bradleyasu/TimeBlaster_Services/assets/brand/joctv-timeblaster.png

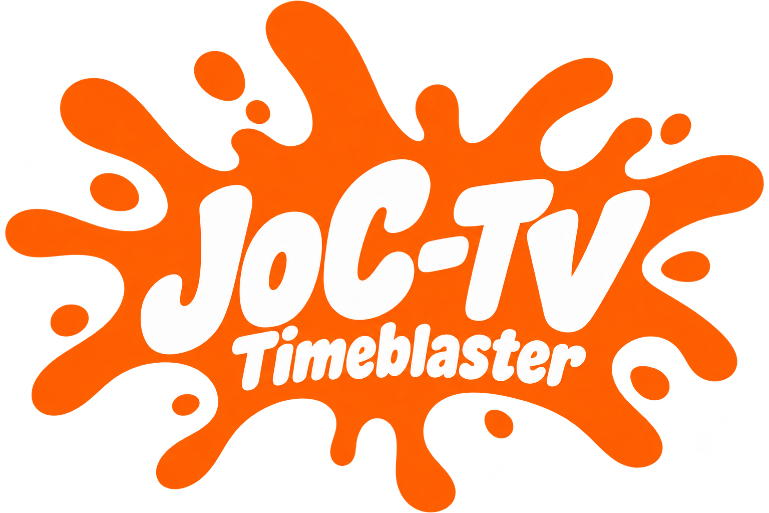
assets/brand/joctv-timeblaster.png
