bradleyasu/TimeBlaster_Services/deploy/assets/booting.png

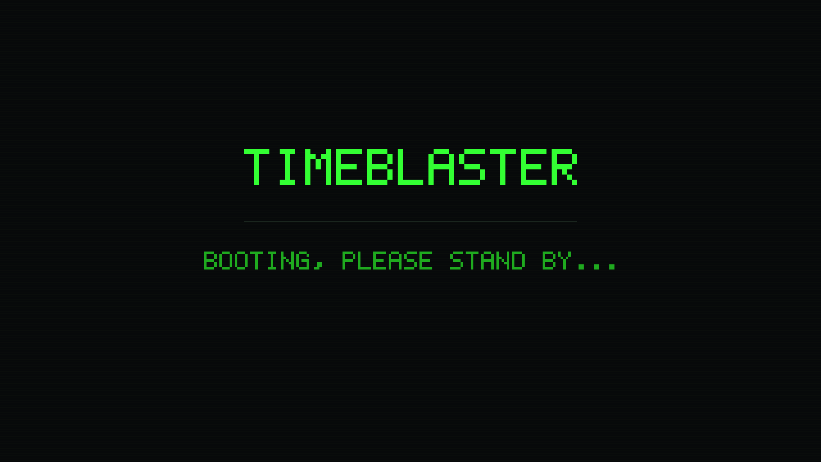
deploy/assets/booting.png
