bradleyasu/TimeBlaster_Services/deploy/assets/ersatztv-offline.png

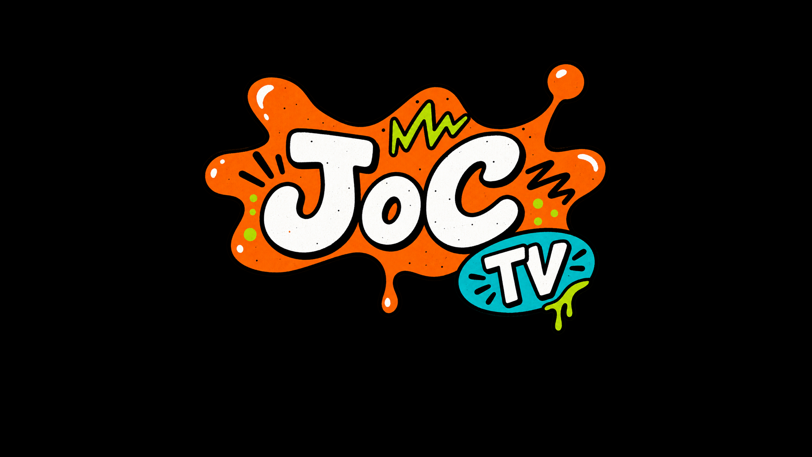
deploy/assets/ersatztv-offline.png
