bradleyasu/TimeBlaster_Services/deploy/assets/no-channel.png

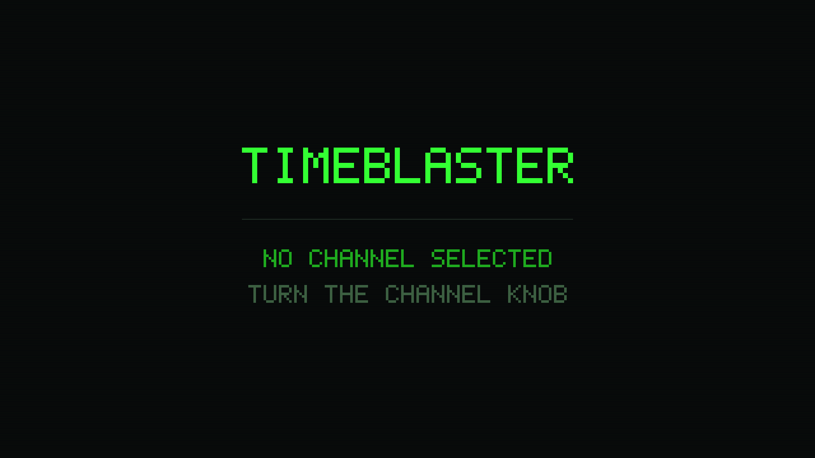
deploy/assets/no-channel.png
