bradleyasu/TimeBlaster_Services/firmware/timeblaster-nano/src/Protocol.h

#ifndef TIMEBLASTER_PROTOCOL_H
#define TIMEBLASTER_PROTOCOL_H

#include <Arduino.h>

// The TB1 wire format spoken with the Raspberry Pi over USB CDC serial.
//
//   <STX> TB1 | SEQ | TYPE | arg | arg ... | CRC <LF>
//    0x02  ^------------ checksummed region ------^   0x0A
//
// The same format is implemented in Go in internal/protocol, and that package's
// tests pin the exact bytes and cross-check this CRC against a transcription of
// the implementation below. A change on either side that breaks compatibility
// fails a test rather than a bench session.
//
// See docs/serial-protocol.md for the full specification.

static const char PROTOCOL_STX = 0x02;
static const char PROTOCOL_ETX = '\n';
static const uint16_t PROTOCOL_MAX_FRAME_LEN = 512;
static const uint16_t PROTOCOL_MAX_SEQ = 4096;
static const uint8_t PROTOCOL_MAX_ARGS = 6;

// A decoded inbound frame.
struct Message {
  String type;
  String args[PROTOCOL_MAX_ARGS];
  uint8_t argc;
};

// CRC-8, polynomial 0x07, init 0x00.
uint8_t protocolCRC8(const char* data, size_t len);

// Sending. Each returns once the frame has been written to Serial, or
// immediately without sending if the transmit buffer has no room for it -- see
// protocolDroppedFrames. Nothing here ever blocks waiting for the host.
void protocolSend(const String& type, const String* args, uint8_t argc);
void protocolSend0(const String& type);
void protocolSend1(const String& type, const String& a);
void protocolSend2(const String& type, const String& a, const String& b);

// protocolSendPing sends the liveness beacon: uptime, the dropped-frame count,
// and the firmware version. The version rides on every PING rather than only
// on HELLO because HELLO is easily missed -- the Nano sends it once at boot,
// often before the Pi has opened the port, and a restarted daemon never sees
// it at all. The Pi needs the version to know whether an update is available.
void protocolSendPing(uint32_t now, const char* version);

// protocolDroppedFrames counts frames abandoned because the USB CDC transmit
// buffer was full, rather than blocking loop() waiting for the host. Reported
// in every PING, so a transmit path that is quietly discarding everything is
// visible from the Pi instead of only at the device.
uint32_t protocolDroppedFrames();

// protocolLastTxOkMs is millis() at the last frame actually written, or zero if
// nothing has been sent yet.
uint32_t protocolLastTxOkMs();

// protocolMsSinceTxOk is how long ago the last frame was written, as seen from
// now. Never negative, even when that frame went out after now was sampled --
// see msSince in Protocol.cpp for why that matters.
uint32_t protocolMsSinceTxOk(uint32_t now);

// protocolTxStalled reports whether sending has stopped working while the Pi is
// still being heard from.
//
// That asymmetry is the whole signal. A Nano that cannot transmit has no way to
// report it, so it has to notice by itself: messages keep arriving, nothing
// leaves, and the only cure is a restart.
bool protocolTxStalled(uint32_t now, uint32_t lastRxMs,
                       uint32_t txStallMs, uint32_t rxFreshMs);

// protocolResetTxHealth forgets the transmit history, for tests and after a
// deliberate re-initialisation.
void protocolResetTxHealth(uint32_t now);

// protocolPoll reads available bytes and invokes handler for each complete,
// checksum-valid frame. Anything before an STX is discarded, which is how the
// link resynchronises after a reset or a half-transmitted frame.
void protocolPoll(void (*handler)(const Message&));

#endif // TIMEBLASTER_PROTOCOL_H
