bradleyasu/TimeBlaster_Services/(commit log)

2026-09-18 Timeblaster: Raspberry Pi alarm clock and television appliance
    A complete appliance stack: a Go daemon (timeblasterd) that owns alarm
    scheduling, hardware I/O, television playback and a companion PWA; a
    privileged network helper; and Arduino Nano ESP32 firmware.
    The design rule throughout is that the alarm clock is the highest-priority
    function and nothing else may compromise it. internal/alarm depends only on
    storage, a clock and an audio sink; the health endpoint reserves "unhealthy"
    for an impaired alarm path; alarms ring with every sound file deleted, with
    the database read-only, and with ErsatzTV, mpv, the Nano and the network all
    broken at once.
    Every out-of-process dependency sits b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
2026-09-22 firmware: drive the display with the proven 74HC595 driver
    The display firmware I wrote assumed directly driven, multiplexed,
    common-cathode digits on twelve GPIO pins. The real hardware is nothing like
    that: four 74HC595 shift registers on three pins (D5/D6/D7), one register per
    digit, latched and not multiplexed, driving two common-anode HDSP-K511 dual
    displays through 32 x 360R resistors.
    Every assumption differed. The segment bit order is A,B,F,G,C,D,E,DP from bit 7
    rather than a=bit0; segments are active low, so the driver inverts before
    shifting; the first byte clocked out lands on the rightmost digit; and ~OE is
    tied low, so there is no hardware dimming at all. My LED pins for Wi-Fi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
    [Arduino.cpp, Arduino.h, Display.cpp, Display.h, Inputs.cpp, Inputs.h, Pins.h, Protocol.cpp]
2026-09-22 Make the display a switch, and animate while the Pi boots
    The 7-segment display has no dimmer: the 74HC595s' ~OE is tied low and is not
    brought out on J2. A 0-100 brightness slider that did nothing except at zero was
    a lie, so the display is now a switch everywhere it is exposed:
    general.display_on, a toggle in the companion app, and hardware.SetDisplayOn.
    The wire format is deliberately unchanged. DISPLAY|BRIGHTNESS keeps its 0-100
    field so a board with ~OE wired would need no protocol change; the Pi now only
    ever sends 0 or 100, and the firmware blanks at 0 and lights otherwise. The
    firmware, the protocol package and the interop fixture are all untouched.
    Devices that stored a brightness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
    [Display.cpp, test_firmware.cpp]
2026-09-22 Make the television boot like an appliance, not a Linux box
    Three separate things showed on HDMI before mpv got the display, and each
    needed its own fix. Kernel messages and the Raspberry Pi logos: quiet,
    loglevel=3, logo.nologo, and console=tty3 so anything slipping past lands on a
    VT the television never shows. systemd's [ OK ] lines: systemd.show_status.
    And the one that actually mattered -- the Debian login prompt, which would sit
    on the television forever if the daemon ever failed to start.
    The getty on the television's VT is now disabled, with one enabled on tty2 in
    its place. Without that escape hatch a Pi with no network and no serial console
    would have no way in at all; SSH is unto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
2026-09-22 Fix five faults found on the first real install
    Diagnosed over SSH on the Pi rather than from the symptoms alone.
    1. Two units declared RuntimeDirectory=timeblaster as different users, so
    whichever started first owned /run/timeblaster. The root wifi helper won and
    created it 0750 root:root, leaving the unprivileged daemon unable to write
    its mpv IPC socket, write its fallback alarm tone, or even traverse the
    directory to reach the helper's own socket. That one race produced three of
    the four red lines in tbctl health: tv_player, alarm_sounds and wifi_helper
    (and network, which follows from wifi_helper). The journal named it exactly:
    "connect: permission denied" on mpv-t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
2026-09-22 ersatztv: read channels from the IPTV playlist, not the authenticated API
    On the Pi, ErsatzTV v26.10.0 answers /api/channels with 401 to an anonymous
    caller, so Timeblaster reported ersatztv down against a server that was fully
    healthy and serving its web UI. The IPTV playlist at /iptv/channels.m3u is open
    -- it is what Plex, Jellyfin and Kodi consume -- and carries everything needed:
    channel-number, tvg-name, and the stream URL.
    Switching to it means no credentials and no configuration to discover channels,
    and it keeps working if the API's auth rules change again.
    The parser is pinned against a playlist captured verbatim from the running
    server, and covers the shapes that would otherwise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
2026-09-22 setup.sh: reload systemd when any unit changes, not just the timeblaster ones
    install_services only reloaded when one of its own two units changed, so a
    rewritten ersatztv.service landed on disk and was then ignored: systemd printed
    'unit file changed on disk, run daemon-reload' and the restart that followed
    reran the stale unit. The FFmpeg PATH change looked installed and did nothing.
    Any unit write now sets a flag and systemd is reloaded once, before the
    services are enabled and started.
2026-09-22 setup.sh: always reload systemd, do not try to be clever about it
    The conditional reload was a bug factory. A unit could be correct on disk while
    systemd still ran a stale copy -- which is what happened to ersatztv.service:
    one run rewrote it without reloading, the next saw the file already matched and
    skipped, and systemd kept the old copy either way. Two runs in a row, neither
    wrong on its own, and the FFmpeg PATH never took effect.
    A daemon-reload costs a few hundred milliseconds and is idempotent.
2026-09-22 docs: explain ErsatzTV's hardware-acceleration warning on a Pi
    ErsatzTV reports every channel as 'not configured for hardware acceleration
    (Nvenc)' on a Raspberry Pi. It is a false positive and acting on it breaks
    playback: NVENC is NVIDIA's encoder and there is no NVIDIA GPU, and the Pi 5
    has no hardware video encoder at all -- the Pi 4's H.264 block is gone, leaving
    an HEVC decoder and the camera ISP. Both h264_nvenc and h264_v4l2m2m fail
    outright on the device, which is what the note records.
    Leaving hardware acceleration set to None is the only correct setting there.
    The lever that matters on a Pi is not transcoding at all.
2026-09-22 One decider for the television, applied in order
    On the Pi, with the channel knob connected, ErsatzTV coming up produced these
    two lines three milliseconds apart:
    11:42:12.493 channel change number=1 name=ErsatzTV
    11:42:12.497 no channel selected; showing the static image
    The knob had chosen channel 1 and the standby image immediately overwrote it.
    The television played the channel while the daemon reported no channel
    selected, so /api/state, the companion app and the overlay were all wrong.
    Two faults compounding. Refresh announced the new channel list -- which makes
    the knob re-evaluate and select, asynchronously, because loading a stream takes
    seconds and must not block the input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
2026-09-22 Hold the channel banner until the picture arrives
    The banner hid on a fixed 2.5s timer measured from when the channel was
    requested, but tuning takes longer than that: watching mpv's event stream on
    the Pi, playback-restart lands about 1.3 seconds after the request when the
    channel is warm, and considerably later when ErsatzTV has to cold-start it. So
    'CH 1' appeared over the previous content, expired, and the picture turned up
    seconds afterwards with nothing on screen to explain the wait.
    A television keeps the channel number up until the picture does. The banner now
    holds until mpv reports playback-restart and only then runs its normal course,
    with channel_overlay_max_hold as a safety net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
2026-09-24 Fix a doubled space in sound names with a separator
    displayName inserts a space for a '-' or '_' separator and another at a
    letter-to-digit boundary. With "alarm_1" both rules fire on the same
    position, so the library offered "Alarm 1".
    The existing test only covered "alarm1", which takes neither path, so
    the form real files are named in was never exercised. Tracks whether a
    separator already supplied the space.
2026-09-24 Make Wi-Fi setup survive a failed join
    Four defects, each of which left the device in a state the user could
    not get out of without physical access.
    The captive portal binding 10.42.0.1:80 failed whenever anything else
    held the wildcard :80. EnterSetup logged that and carried on, so the
    access point came up with no portal behind it: the Pi had already left
    the user's network and could be neither reached nor configured until the
    fifteen-minute timeout expired. It now rolls back.
    The join itself never worked. `nmcli device wifi connect` infers the
    security type from the scan list, and a radio coming straight out of
    access-point mode has no usable scan, so the passphrase was attached to
    a pro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
2026-09-24 Say what the device is doing during a channel change
    A cold tune takes around nine seconds on a Pi 5, nearly all of it
    spent encoding the first HLS segment, and mpv holds the outgoing
    channel's last frame until the new one decodes. The wait therefore
    looked exactly like a picture that had frozen.
    The television now shows a full-screen card -- channel number, animated
    dots, painted over the frozen frame -- drawn before the load rather
    than after it, so it is up before the old picture stops moving. The
    seven-segment display flashes the channel the way a television does.
    Anything that writes to the display takes a claim generation, so a
    banner timing out cannot wipe a message something else h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
2026-09-24 Find Go by path when it is not on PATH
    setup.sh installs Go under /usr/local/go, which Raspberry Pi OS adds to
    no shell's PATH -- not even a login one. `make build` on the Pi
    therefore failed with "go: command not found", which is exactly what
    `make update` needs to work.
2026-09-25 Reject impossible alarm times instead of clamping them
    A number input does not stop anyone typing 75, and the editor quietly
    turned that into 23 in 24-hour mode, or into midnight in 12-hour mode.
    The alarm saved, reported success, and went off at a time the user never
    asked for -- which is the one failure an alarm clock cannot have, and a
    silent correction is indistinguishable from it having worked.
    The two fields were also inconsistent: the hour clamped locally while
    the minute was passed through untouched and rejected by the server with
    a 400, so the same class of mistake produced two different behaviours.
    editorTime now validates both and reports which field is wrong, marking
    it until i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
2026-09-25 Fix a stale assertion left by the rename to editorTime
    editorHour24 became editorTime when the editor started rejecting
    impossible times rather than clamping them, and the test still named
    the old function. It was pushed red.
    Also checks that saveAlarm looks at the returned error, so the clamping
    behaviour cannot quietly come back with the function keeping its name.
2026-09-25 Stop a knob that is not there from setting the alarm volume
    The alarm volume wandered between 10% and 22% on its own. The volume pot
    is not wired to the Nano yet, and an unconnected analog pin does not
    read zero -- it floats at whatever charge its input capacitance holds,
    coupled from the neighbouring channels of the multiplexed ADC.
    Measured over ten samples with nothing attached:
    channel (connected) 1.000 every sample
    volume (floating) 0.128 .. 0.219
    reserved A 0.085 .. 0.134, rising and falling with volume
    That last correlation is the giveaway: the two floating pins move
    together, which is crosstalk rather than anything either of them is
    measuring.
    The knob is auth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
2026-09-28 Load cdc_acm at boot so the serial port stays reachable
    If the Pi boots with the Nano detached and it is plugged in afterwards,
    the daemon can never open the port. It retries forever against
    "operation not permitted" and only a restart clears it.
    The cause is an ordering race with systemd's device filter. The unit
    hardens itself with
    DeviceAllow=char-ttyACM rw
    and systemd resolves "char-ttyACM" by looking "ttyACM" up in
    /proc/devices at the moment it builds the service's cgroup filter. That
    major number comes from cdc_acm, which is not preloaded and only loads
    on demand when the first ACM device enumerates. If that has not happened
    yet, systemd finds no entry, silently drops the rule, a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
2026-09-29 Show the alarm volume on the clock while the knob moves
    Turning the volume knob now puts the level on the seven-segment display
    the way a stereo does, and the clock returns about a second and a half
    after the knob stops.
    "V" and a right-aligned number is exactly the four cells available for
    every value from 0 to 100 -- "V 0", "V 44", "V100" -- so there are no
    special cases. V rather than U because this font draws it with a pointed
    base, which no digit resembles.
    Only a physical turn shows it. A change made from the companion app
    would otherwise flash the clock at someone who is not in front of the
    device.
    Each turn re-claims the display and restarts the timer, which the claim
    generation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
2026-09-29 Stop the guide's channel chips touching the REFRESH button
    .row-head is a flex container, so the heading's own bottom margin sits
    inside it and leaves no space below. The TV tab gets away with it
    because a .hint follows, bringing its own spacing. In the guide the
    chips follow directly and had no top margin, so two tappable controls
    met with nothing between them.
2026-09-29 Clear the playback handle when a preview hits its time limit
    watch had two exits and only one of them cleaned up. A preview that ran
    to its time limit stopped the player and returned, leaving the handle
    set for the rest of the service's life. IsPlaying then reported true
    forever, so the companion app showed a preview still playing long after
    the speaker had gone quiet.
    Observed on the device: the card went Running at 1s and Stop at 10s
    exactly as configured, while /api/state still said playing at 20s.
    Both paths now converge on the same cleanup. A stop we asked for is not
    recorded as a player failure, which it otherwise would be -- the process
    reports being killed, and that is the answer t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
2026-09-29 Raise the sound preview cap to 60 seconds
    Ten seconds is too little to judge an alarm sound: the files here run
    for minutes, so a preview was playing about four per cent of one.
    Still a cap rather than the whole file, because without one the only way
    out of a preview is the stop button.
2026-09-29 Send the television's audio to HDMI, with a switch for the speaker
    mpv was launched with --audio-device=auto, which follows the ALSA
    default. ALSA's default is card 0, and cards are numbered in enumeration
    order -- so plugging in the USB speaker made it card 0 and the
    television's sound started coming out of it.
    Observed on the device after the speaker was fitted:
    0 [UACDemoV10]: USB-Audio - UACDemoV1.0
    1 [vc4hdmi0 ]: vc4-hdmi - vc4-hdmi-0
    2 [vc4hdmi1 ]: vc4-hdmi - vc4-hdmi-1
    The same card had been number 2 earlier the same day.
    The device is now always chosen by card name, and HDMI is the default
    even when the attached display has no speakers: a monitor that cannot
    make a noise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
2026-09-29 Make the TV audio test actually test the speaker branch
    It asserted only that the device string contained "CARD=". Falling
    through to HDMI produces a CARD= string too, so the assertion held
    whether the speaker branch ran or not -- disabling that branch entirely
    left the test green.
    It now names the resolved speaker card and rejects an HDMI device.
2026-09-29 Reload playback when the TV audio output changes
    Setting mpv's audio-device does nothing to a stream that is already
    playing. When an audio output fails to open -- an HDMI sink with no
    speakers behind it -- mpv gives up on audio for that playback session
    and leaves the track deselected. Pointing it at a working device
    afterwards changes nothing, and selecting the track by hand is silent
    too, because the output object was never created.
    Observed on the device: aid=False with an aac track present, setting
    aid=1 selected it, and the USB card still read Stop. Reloading the file
    brought it up Running and it stayed there.
    Changing the setting now reloads whatever is on screen. The reconnect
    path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
2026-09-29 Use the alarm list's switch for the settings toggles
    Bare checkboxes beside the alarm list's switches looked like two
    different applications. The three settings toggles now use the same
    control.
    No JavaScript changed: the inputs keep their ids, so reading .checked
    still works. .field > span and .field.toggle > span both use the child
    combinator, so nesting a switch inside a label does not collide with the
    label's own text styling.
    A test pins the structure. The switch is styled through
    `.switch input:checked + span`, an adjacent sibling selector, so the
    track has to come immediately after the input -- get that wrong and the
    control renders but never visibly changes state, which looks dead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
2026-09-29 Apply settings as they are changed and drop the save button
    Every control now saves itself, matching the alarm list's switches,
    which have always worked this way: act on change, say nothing on
    success, snap back with an explanation if the device refuses.
    Two things needed care. The API compares a whole settings document
    rather than patching fields, so each request is built from the controls
    rather than from the last saved copy -- two changes in quick succession
    then both survive, because each request carries the complete intent and
    the later cannot undo the earlier.
    The timezone is the exception. It is typed rather than chosen, so
    mid-edit its value is half a word that would fail validatio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
2026-09-29 Trust a hardware clock that survived the power cut
    The seven-segment display holds its loading animation until the system
    clock is trustworthy, and the only thing that counted as proof was
    systemd-timesyncd's synchronized marker. That marker is an NTP-only
    signal, so fitting the RTC coin cell -- which fixes the exact problem
    the wait exists for -- bought nothing: the Pi knew the time at boot and
    still animated for half a minute.
    17:35:36 rpi-rtc: setting system clock to 2026-09-29T21:35:36 UTC
    17:35:45 holding the clock display until the system clock is synchronised
    17:36:11 system clock synchronised; sending the time to the Nano
    Read /sys/class/rtc/rtc0/since_epoch as a sec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
2026-10-01 Stop a dead channel wedging the Nano, and report it when it does
    Three faults that combined into one silent failure. Channel 1 cannot be
    served by ErsatzTV, so its stream ended the instant it loaded and the
    reload-on-failure path retried it forever: 22541 reloads in 19 hours.
    Every channel change flashes the number on the seven-segment display, so
    that loop also put tens of thousands of unsolicited writes down the
    serial link. Some hours in the Nano stopped transmitting altogether and
    never resumed -- 15 hours mute, zero bytes on a raw read, while still
    enumerated on the bus.
    None of it showed up. The status page read OK because Connected meant
    "the port opened", and LastMessageAt was stamp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
    [Arduino.h, Protocol.cpp, Protocol.h, test_firmware.cpp]
2026-10-01 Stop a wedged Nano filling the journal and churning the PWA
    A board that opens but never answers made the reconnect loop succeed and
    fail every heartbeat window, and every cycle was logged in full: six
    lines each, 39478 of them overnight, none saying anything the first three
    had not. Each cycle also emitted a LinkUp/LinkDown pair, and since every
    hardware_changed event makes the app refetch the whole snapshot, it was
    costing two full refetches per cycle in every connected phone.
    - Send LinkUp when the Nano first speaks rather than when the port opens,
    and LinkDown only if LinkUp was sent. An open port is not a working
    link. Resync still runs at connect, because putting the time on the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
2026-10-01 Report free disk space as a health component
    The device has 20GB free on a 469GB card that is 96% full of media, and
    nothing on it could say so. Running out does not fail loudly: SQLite stops
    being able to checkpoint and ErsatzTV stops being able to write its
    database, with no indication of why. This makes the decline visible while
    there is still room to act on it.
    system.Statfs reads the filesystem, behind a Disk interface so the
    thresholds are testable without filling a real disk. AvailBytes is used
    rather than total free space, because the reserved-for-root fraction is
    space this daemon cannot actually have.
    Thresholds are configurable and default to 5 GiB degraded, 1 GiB down.
    The firs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
2026-10-01 Cap persistent logging instead of discarding it at reboot
    Raspberry Pi OS ships Storage=volatile to spare the SD card write wear, so
    the journal lived in RAM and every log was lost at reboot. That is the
    wrong trade for a device meant to run unattended for months: diagnosing
    the recent Nano fault depended on 15 hours of history that only survived
    because the Pi happened not to restart.
    Overrides it with persistent storage and real bounds: 200M total, 20M per
    file, one month retention, 64M for the runtime journal before /var is
    available.
    SystemKeepFree=1G is the line that makes this work rather than quietly
    fail. It defaults to 15% of the filesystem, which on a 469GB card demands
    roughly 7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
2026-10-01 Stop USB audio freezing the picture, and recover if it does
    Routing television audio to the USB speaker froze playback. Caught in the
    act: ALSA held in PREPARED with appl_ptr=0 -- the device configured and
    never fed a single frame -- and mpv stuck in its startup seek with
    time-pos pinned at 0. No kernel or USB events, the device still
    enumerated, every mpv thread in futex_do_wait, so nothing was blocked in
    the driver. It sat frozen for six minutes until a channel change cleared
    it.
    The speaker accepts exactly one format: S16_LE / 2ch / 48000, one altset,
    full speed, bus powered. Roughly half the library is 44.1 kHz, and because
    the channels are HLS Direct with -c:a copy the source rate reac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
2026-10-01 Show install instructions instead of the app in a browser
    Opened as a web page the companion app now shows how to add it to the home
    screen and nothing else: body.gated hides every other section plus the tab
    bar and the connection dot, and the app is never wired up, so it does not
    connect, poll, or call the API while gated.
    Instructions are per browser, because the only question that matters --
    which menu hides Add to Home Screen -- is a question about the browser and
    nothing feature-detectable answers it. iOS Safari gets the Share sheet
    steps; iOS Chrome and Firefox are told to open Safari, since on iOS only
    Safari can install; Chromium gets its menu or address-bar install, and a
    real one-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
2026-10-01 Use the hand-made JoC-TV logo for the app icon
    The icons were a splat drawn in primitives, standing in for artwork that
    did not exist yet. It does now, so they are derived from it instead:
    redrawing a hand-made logo in code would be a copy that drifts from the
    original every time either changes.
    assets/brand/joctv-timeblaster.png is the master. make-assets.py grows a
    small stdlib PNG decoder, a box-filter resize and an alpha composite to
    derive the icons from it -- stdlib because the Pi has no image library and
    setup.sh regenerates assets there. A box filter rather than nearest
    sampling: this is a large reduction and point-sampling fine white
    lettering breaks the strokes.
    The logo is lands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
2026-10-01 Show an offline screen when the Timeblaster cannot be reached
    Losing the device left the app looking broken rather than offline: refresh()
    swallows its error by design, so every panel simply rendered empty with a
    dimmed dot in the corner as the only clue.
    A full-screen overlay now says so plainly, with the logo, what to check, and
    when the device was last reached. It is an overlay rather than a body class
    like the install gate because this state is transient -- the app keeps its
    state underneath and comes back intact the moment the device answers.
    Two grace periods, because the two cases look identical to the code and very
    different to a user. A session that has connected before is usually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
2026-10-01 Set alarm times with the platform's time picker
    Setting an alarm meant typing into two number fields and tapping an AM/PM
    pair, which raises a keyboard on a phone for something every platform already
    has a wheel for. A native time input replaces all three: on iOS it is the
    Clock app's hour / minute / AM-PM drums, on Android the platform picker, on a
    desktop a spinner field.
    Most of what the old controls needed in code goes with them. A picker cannot
    express 75:43, so the hour and minute range checks that existed to catch it
    are gone, along with the 12-to-24 hour conversion and the AM/PM radio pair --
    the value is always 24-hour HH:MM however it is displayed.
    editorTime still rejects rather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
2026-10-03 Let the Nano restart itself when its transmit path dies
    Second occurrence of the same fault: the USB CDC transmit path stops working
    while everything else keeps running. The display updates, messages from the
    Pi still arrive, and nothing the Nano sends ever gets out again. Last night
    it went mute mid-burst while the knob was being turned, and stayed mute.
    The guard added last time did not prevent it, and could not have. That was
    built on the theory that a blocking Serial.write was stalling loop(), but
    loop() is demonstrably alive -- the clock on the display stays correct, and
    it is redrawn there. Only transmitting is dead. On an ESP32-S3 with native
    USB that points at the TinyUSB side wedgi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
    [Protocol.cpp, Protocol.h, main.cpp, test_firmware.cpp]
2026-10-03 Drop the channel-overlay switch from the app; it is always on
    A front-end change only, as asked: the device keeps the setting, the storage
    key and the plumbing, so re-adding the control later is putting the markup and
    the three lines of wiring back.
    The one subtlety is that the field still has to be sent. applySettings
    compares the whole settings document against what the device holds, so a
    missing bool decodes as false, differs from the stored true, and switches the
    overlay off -- permanently, because the control that could undo it is the one
    being removed. It now sends true unconditionally, with a guard that fails if
    that ever stops being the case.
    Verified the stored value on the device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
2026-10-03 Only report dropped frames that accumulate while we are listening
    The warning fired on every boot for normal behaviour. The Nano pings into
    the void whenever nothing holds the port open -- every moment between it
    powering up and the daemon connecting, and every service restart -- so the
    first count of a session is almost always non-zero and almost always means
    nothing. It reported 233 on this device within seconds of starting, which is
    about eight minutes of talking to nobody.
    The first count of a session is now adopted as a baseline, and only growth
    after that is reported: frames the firmware is generating and cannot get out,
    which is the symptom worth chasing. A count going backwards is a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
2026-10-05 Add a Settings switch for Raspberry Pi Connect, off by default
    Connect installs itself as an enabled user service with lingering on, so it
    runs continuously from the moment the Pi boots. This turns it into something
    deliberate: off unless asked for, and off again after a restart unless the
    preference says otherwise.
    It lives in the existing root helper rather than a second privileged service,
    because "exactly one component runs as root" is a property worth keeping and
    the RPC that guards it already exists. Three new ops, validated like the rest.
    Connect's units are *user* units. A plain systemctl as root reaches root's own
    user manager, where Connect is not configured, and the switch would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
2026-10-05 Simplify the remote access hint
    The old text explained the restart behaviour and when to use it, which is
    more than the switch needs to say.
2026-10-08 Flush journald on every setup run, and test the deploy tree is committed
    Two gaps the first install from a clean checkout found.
    Persistent logging was not actually on afterwards. setup.sh installed the
    drop-in and restarted journald, but a restarted journald keeps writing to the
    runtime journal in RAM until something moves it to /var/log/journal -- at boot
    systemd-journal-flush does that, and mid-install nothing did. The re-run made
    it worse: it found the drop-in "already current", skipped the step, and never
    flushed at all. On the new card /var/log/journal was 4.0K until a manual
    `journalctl --flush` took it to 8.1M. The flush now runs unconditionally; it is
    idempotent, so doing it every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
2026-10-15 Shut the Timeblaster down by holding the big red button for ten seconds
    Nothing shows for the first two seconds, so an ordinary press never puts a
    digit on the display. Then it counts 8, 7, ... 0 and switches to the loading
    animation while the Pi shuts down. Letting go before 0 cancels.
    The hold is timed on the Nano, which is the one piece of application policy
    the firmware owns, and it owns it for safety. The Pi only sees press and
    release messages; if it timed the hold and a release were lost -- and this
    link has dropped frames -- it would believe the button was still down, and an
    ordinary press would power the device off ten seconds later. On the Nano the
    button, the timer and the displa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
2026-10-19 Stop the Nano restarting itself on a PING it sent successfully
    The transmit self-heal added in 8ae1f26 has been restarting a working Nano.
    On cold boots it showed as the display falling back to the loading animation
    and replaying the volume and channel banners, sometimes several times.
    loop() samples millis() once, then sends a PING; the send stamps txLastOkMs
    with a fresh millis(). If the clock ticked during the write, txLastOkMs was a
    millisecond *after* the `now` given to the stall check, and `now - txLastOkMs`
    in unsigned arithmetic is not -1 but about 4.29 billion -- "nothing sent for
    49 days". So right after a PING that went out fine, the Nano declared its
    transmitter dead and restart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
2026-10-19 Update the Nano's firmware from a button in the companion app
    The Timeblaster now ships its own Nano image (deploy/firmware, installed to
    /usr/local/share/timeblaster/firmware) and can flash it over USB. The System
    tab shows the running and available versions, and UPDATE FIRMWARE is enabled
    only when the image differs from what a live Nano reports. Nothing else ever
    starts an update.
    An update: the link releases the serial port (Pause), the root helper runs
    dfu-util -d 2341:0070 -R -D <image>, the link resumes, and the update only
    counts once the Nano reports the new version over PING. Success from dfu-util
    is judged by "Download done.", since -R makes it exit 251 after a flash that
    worked.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
2026-10-20 Add a mode knob, with ambience mode alongside ErsatzTV
    Pot 2 is now the mode knob. Its travel is divided between the modes listed in
    input.mode_knob -- by default TV and ambience -- with the channel knob's
    hysteresis, and the channel knob then chooses within the mode.
    Ambience mode plays local videos from numbered folders under
    /srv/timeblaster/ambient (ch1, ch2-rain, ...). A folder's videos play in
    natural order (2.mp4 before 10.mp4) and repeat; a single video loops inside
    mpv via a per-file loop-file option, which is seamless and ends with the file
    so it cannot leak into TV mode. Broken videos are skipped with a backoff and a
    folder where nothing plays is given up on; a stall watchdog rel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
2026-10-25 Calibrate the channel knob to the printed marks on its dial
    With the dial in its housing, the pot no longer turns through its full travel,
    and equal slices of that travel do not land on the marks. input.channel_marks
    takes the raw reading measured at each mark; the knob then selects the nearest
    mark, with the usual hysteresis measured between neighbouring marks, so mark N
    is channel N whatever the spacing, taper or channel count. Turning past mark 1
    or the last mark stays on it, and a mark with no channel behind it -- marks 3
    to 5 in a two-channel ambience mode -- shows standby. Marks may run in either
    direction, and skip the end margins that would snap a mark near an end onto it.
    The snaps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
2026-10-25 Add guide mode: the listings, with the channel in the corner
    The mode knob now has three modes, TV, guide and ambience, in thirds. Guide
    mode shrinks the picture into the top-left quarter (mpv's video margins) and
    draws the rest of the screen as an old cable-guide channel: the time, what is
    on the corner channel now, and a 90-minute grid in half-hour columns, five
    channels to a page, turning every 8 seconds and jumping to the corner
    channel's page when it changes. The channel knob, and the companion app,
    choose the corner channel.
    The corner video is the TV mode's own playback, borrowed rather than
    reimplemented, so it reloads, recovers from stalls and gives up exactly as the
    full-screen pi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
2026-10-25 Cover the guide's corner with a tuning card while a channel comes up
    mpv holds the old channel's last frame until the new one decodes, which can
    take several seconds when ErsatzTV has to start a channel. In TV mode the
    full-screen tuning card hides that; the guide suppresses the card so as not to
    cover itself, which left the old channel's frozen picture under the new
    channel's listing. The corner now shows the channel number and TUNING until the
    picture arrives, or for 20 seconds at most.
    Claude-Session: https://claude.ai/code/session_01XhMCMb6XLMdKbkTrHA1nZ5
2026-10-25 Give a channel time to start before the stall watchdog calls it stuck
    The watchdog held a freshly tuned channel to the same 12-second limit as one
    that had been playing and froze. ErsatzTV sometimes needs longer than that to
    cold-start a channel, so the watchdog reloaded it just as its picture was about
    to arrive -- restarting the wait and making slow channels slower. It showed up
    as a position-0 "stall" exactly 12 seconds after tuning, seven times in a week,
    in TV and guide mode alike.
    Until a channel has produced its first picture (mpv's playback-restart) it now
    gets mpv.stall_start_timeout, 45 seconds by default; the 12-second limit still
    applies to a picture that freezes after it has st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
2026-10-25 Show the episode and its synopsis in the guide's panel
    ErsatzTV's listings carry a synopsis for nearly every show and an episode
    title for almost everything; the parser read neither the first nor showed the
    second. The guide's top-right panel now shows the corner channel's programme
    title, its episode title (for music videos, the song), the synopsis wrapped
    onto up to five lines and cut with an ellipsis beyond that, and its time slot.
    To make room, the clock moves up beside the header at header size.
    Wrapping is done here rather than left to the renderer, which wraps to the
    screen's edge rather than the panel's: the guide's font is fixed-width, so
    lines break at words exactly within the pan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
2026-10-25 Read the guide's listings from its first column, not from now
    The grid starts at the half hour, but its listings were requested from the
    current time, so a programme that had ended since -- 10:00 to 10:44, seen at
    10:47 -- was dropped, leaving an empty strip at the start of its row. The guide
    now asks for everything overlapping the grid's own window.
    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
2026-10-25 Make pot 3 the TV audio switch: HDMI at one end, USB speaker at the other
    The last unassigned knob becomes a two-position switch for where the
    television's sound goes -- the same choice as the companion app's setting, and
    the same path to it: store the setting, point mpv at the device, reload the
    picture so the device is actually used. Like the other knobs it is
    authoritative: the app's choice holds until the knob next moves, and the knob
    re-reporting its position after a reconnect changes nothing and reloads
    nothing. The display flashes HdMi or USb.
    Its travel is limited by the housing and may never cross the pot's midpoint, so
    it takes the channel dial's mark calibration with two marks, i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
2026-10-25 Flash the channel on the display only when it is a different channel
    Switching the audio output reloads the channel so the new device is used, and
    the reload announced the channel like a change -- flashing Ch.01 a moment after
    the audio knob's HdMi or USb, so the viewer barely saw it. A reload of the same
    channel, whether for the audio, a frozen picture or an mpv restart, now leaves
    the display alone; changing channel, or mode, still flashes the new one.
    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
2026-10-25 Test that reloading the same channel does not flash over the audio switch
    The test belonging to the previous commit, which missed it.
    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
2026-10-29 Fix the guide being cut off at the schedule cache's expiry
    The previous commit named the cache's expiry "until" inside GuideBetween,
    shadowing the window's own end, so every guide -- the companion app's and the
    TV's grid alike -- stopped at the moment the cache next expired, one to two
    minutes away, instead of hours out. A test now asks for three hours and checks
    it gets them.
    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
2026-10-29 Let an in-flight audio knob switch finish before shutdown closes the database
    The knob's switch runs off the input path and writes the setting to the
    database. Stopped at the wrong moment, the daemon could close the database
    under it; in the tests it showed up as a temporary directory still being
    written to during cleanup. Shutdown now waits for any such switch, for five
    seconds at most.
    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
2026-11-02 Turn the Pi's LEDs off: they show through the enclosure
    setup.sh writes a marked block to config.txt turning off the green activity
    LED, the red power LED and the Ethernet port's LEDs, and switches the two board
    LEDs off at once rather than waiting for a reboot. A re-run replaces the block
    rather than adding another. The firmware still blinks them for the first
    moments of a boot, before the kernel applies the settings.
    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
2026-11-02 Back off restoring the standby image instead of reloading it in a tight loop
    With no display attached -- the television off or unplugged at boot -- mpv
    cannot open its video output, so every file it is given ends at once with an
    error. The standby image's recovery restored it immediately every time: 1146
    reloads in 13 seconds on this morning's boot, stopping only when a channel took
    the screen, and resuming whenever a channel gave up. It now restores at once
    the first time and then waits 2 seconds, doubling to a minute, so a television
    left off overnight costs one reload a minute and the picture returns within a
    minute of it coming on. A picture appearing resets the count, and mpv's own
    erro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
2026-11-02 Fix a flaky watchdog test's sanity check
    It demanded ten watchdog checks, but the test advances the fake clock whenever
    any timer waits -- the overlay's too -- so the watchdog can miss an advance and
    it failed about one run in four. Seven checks two seconds apart already span
    past the stall timeout, which is what the check is for.
    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
2026-11-05 Open the companion app by itself once Wi-Fi setup succeeds
    The setup page cannot hear whether joining worked: the setup network shuts
    down the moment the attempt starts, taking the page's connection with it. So
    it now watches for the outcome. The phone drops back to the home Wi-Fi on its
    own; the page asks the companion app's Wi-Fi status every couple of seconds,
    and once the Timeblaster reports itself joined to the network chosen -- not
    just reachable, since over the setup network it answers too -- it opens the
    app, which offers to add itself to the home screen. Setup mode coming back
    shows the helper's error and a retry; falling back to the previous network
    says so and opens the app there;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
2026-11-05 Make Wi-Fi setup impossible to get stuck in
    A first live test of the redirect-to-the-app flow joined the network
    successfully both times -- but the page gave no sign of progress, so after 16
    seconds the Wi-Fi button was held again, which restarted setup; the page then
    reported that as a failed join, tried to rescan with the phone off the setup
    network, wiped the network list on the failure, and left no way to try again.
    And the NFC/QR address showed the install page instead of setup, because the
    hand-off matched the setup IPv4 address while the phone arrived by IPv6.
    - Holding the Wi-Fi button during setup now cancels it and rejoins the saved
    network: a physical way back that needs no wai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
2026-11-05 Say Connected on the display when Wi-Fi setup succeeds, and point the page at it
    Between the setup network closing and the phone rejoining its own Wi-Fi, the
    setup page can hear nothing and just looked stuck on "joining". The display
    can: it now scrolls Connected the moment the Timeblaster has joined -- the
    daemon checks every 2 seconds during setup rather than every 5 -- and the page
    says so for that stretch, in stages: sending the details, then "the setup
    network has closed; watch the display". A setup cancelled from the button
    keeps its own bAcK and is not followed by Connected.
    Claude-Session: https://claude.ai/code/session_01XhMCM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
2026-11-05 Show a Wi-Fi symbol beside the guide's clock
    Slime green when the Timeblaster is on the home Wi-Fi; dimmed with a red slash
    when it is not, which includes setup mode, when it is on its own network. The
    guide's font has no such glyph, so it is drawn: quarter-circle wedges with the
    next one cut out in the background colour, which is how the arcs appear.
    The guide redraws every second, so it reads a cached answer rather than asking
    the helper, whose status runs nmcli: the daemon checks every 10 seconds, and
    entering setup and reporting Connected update it at once.
    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
2026-11-09 Restart the Timeblaster's services with a double tap of the Wi-Fi button
    Two taps within 0.7 seconds restart the daemon -- and with it the TV player,
    the Nano link and the app -- and the Wi-Fi helper: a way to recover a stuck
    picture or a wedged controller with no app and no terminal. A single tap still
    does nothing, so nothing waits to see whether a second is coming, and the
    five-second hold is untouched.
    The restart goes through the root helper as a fixed command with no
    arguments, like power-off; --no-block lets the helper reply before systemd
    stops it. The display shows rEStArt first. It is refused, showing no, while
    an alarm rings (it would be silenced and not rung later), during a fir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
2026-11-09 Don't call a double-tap restart that went through an error
    The helper queues the restart and replies, but systemd can stop it a few
    milliseconds later, before the reply is out: the first live test logged
    "could not restart the Timeblaster services ... reading response: EOF" for a
    restart that happened, and would have flashed Err had the daemon not been
    stopped first. A connection dropping after the request is the restart under
    way, and is now logged as such; a refusal from the helper is still an error.
    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
2026-11-09 Snooze a ringing alarm with a tap of the Wi-Fi button
    While an alarm rings, one tap of the Wi-Fi button snoozes it for that alarm's
    snooze length and flashes SnooZE; the big red button still means off, so a
    half-asleep slap of either does exactly one thing. Snoozing had been
    possible only from the companion app or tbctl.
    The double-tap restart is now refused whenever an alarm is active, snoozed as
    well as ringing: the tap that snoozes is often followed by a sleepy second
    one, and a restart would lose the alarm waiting to ring again. The snoozing
    tap itself never counts towards a double tap.
    Claude-Session: https://claude.ai/code/sessi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
